theapi/dummy_load/README.md

# dummy_load
Constant current dummy load
