theapi/dummy_load/electronic_load.pdf

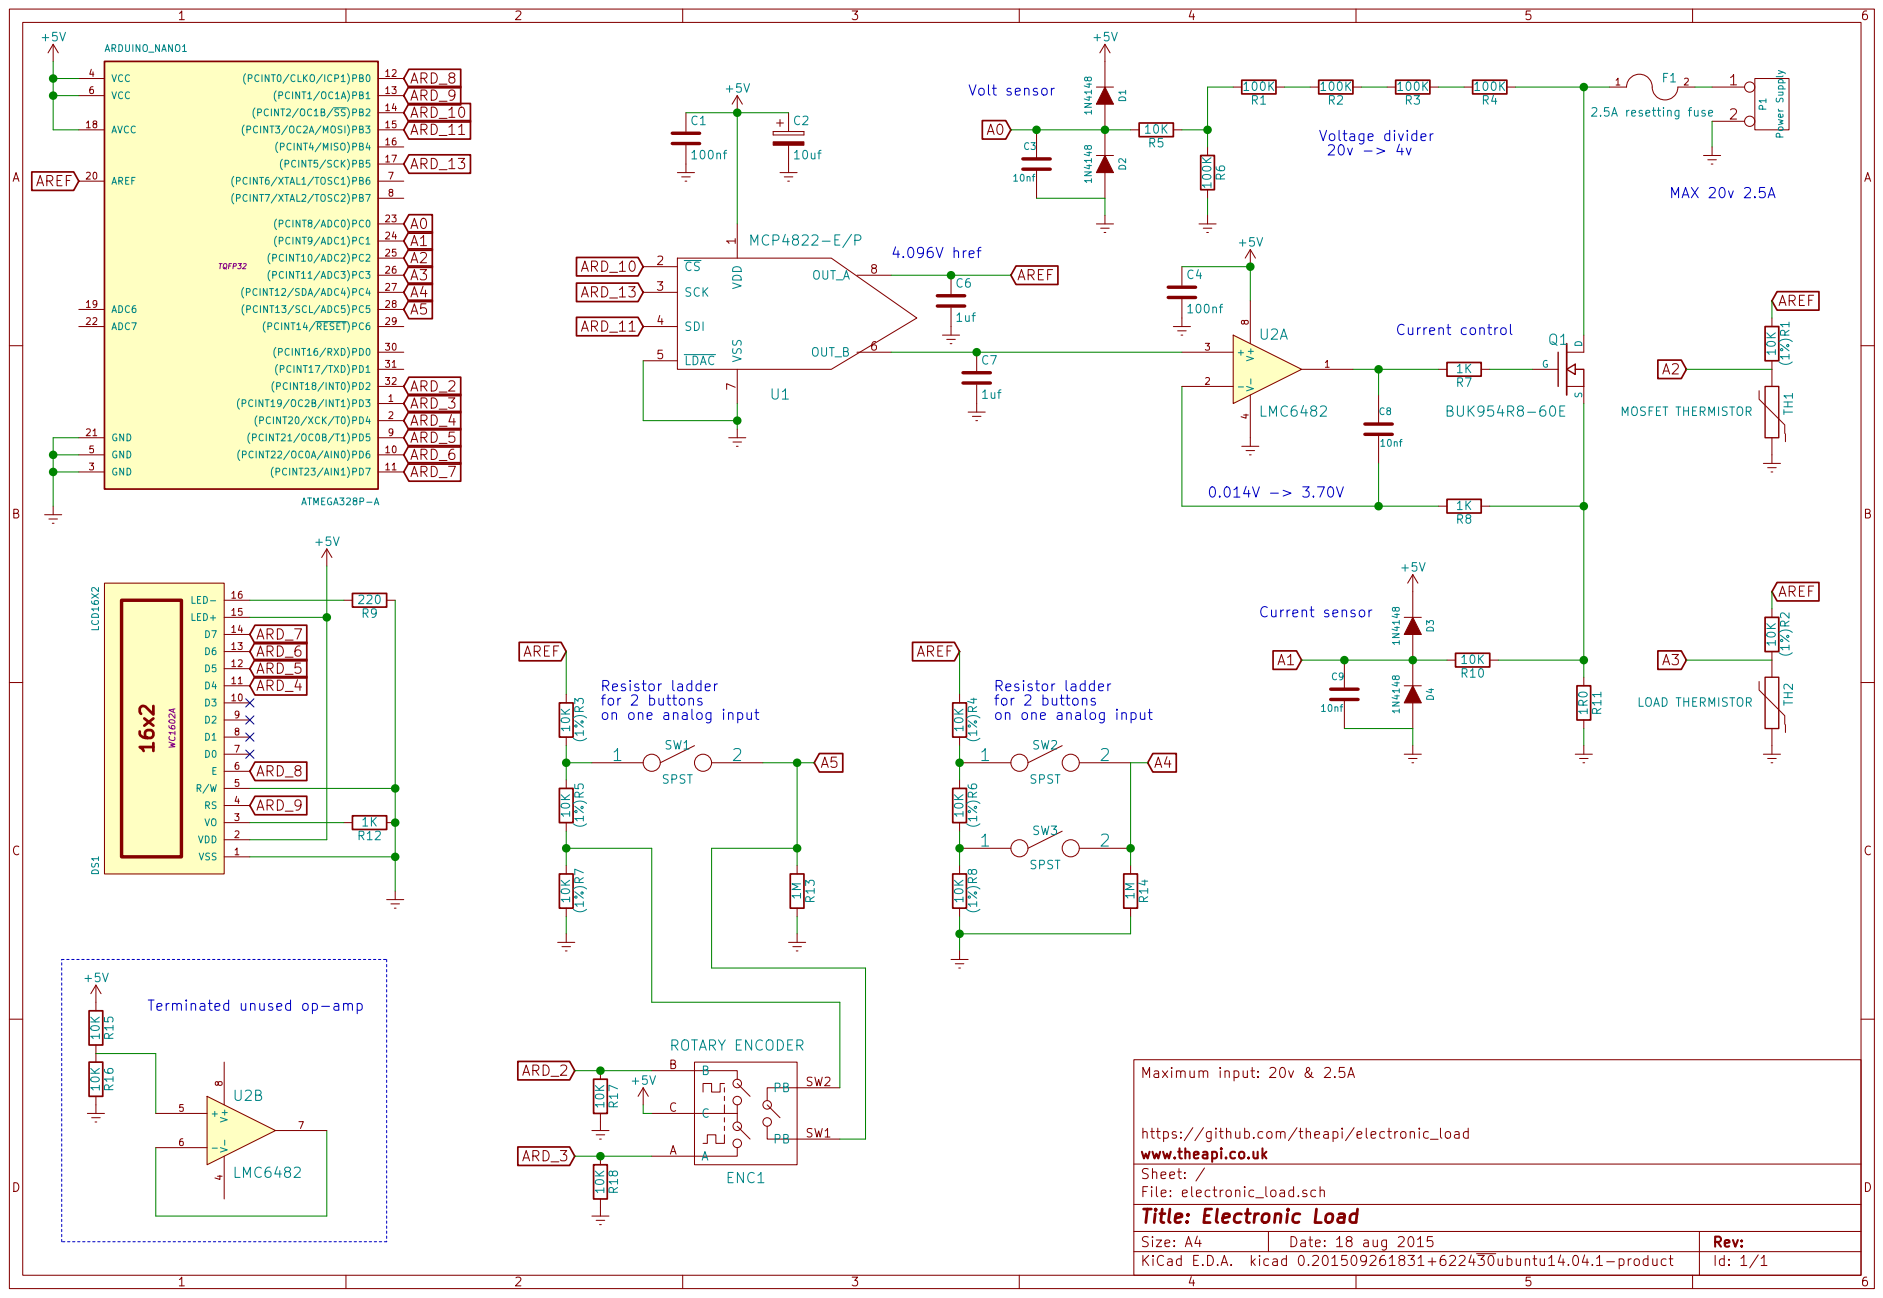
[picture p1: page 1]

for 2 buttons on one analog input

Terminated unused op-amp

https://github.com/theapi/electronic_load
File: electronic_load.sch Sheet: / www.theapi.co.uk

Id: 1/1 Title: Electronic Load
