theapi/dummy_load/(commit log)

2015-08-19 Changed pin assignments
2015-08-19 Schematic pdf
2015-08-19 Start of the rotary encoder
2015-08-19 Read & display the thermistors
2015-08-19 LDAC tied to low so the output latches on the rising edge of the CS pin.
2015-08-20 Read the rotary encoder
2015-08-20 Invert the rotary encoder counter & faster screen refresh
    [dummy_load.ino]
2015-08-21 pulldowns on the rotary encoder
2015-08-23 4v ahref from the adc
2015-08-23 Voltage output from DAC set by the rotary encoder
2015-08-24 Divide 1024 for adc conversion
2015-08-24 Better temperature reading
2015-08-25 Encoder switch
2015-08-25 Encode switch up/down
2015-08-25 Show minimum volts setting
2015-08-26 Resistor ladder
2015-08-26 Thermistor code tidying
2015-08-26 Start of the switches register
2015-08-27 Minimum volts
2015-08-27 Encoder switch on resistor ladder
2015-08-28 Read switches
2015-08-30 Adjust aref output to be 4v
2015-09-04 Blink "V" on setting minimum volts
2015-09-10 Switchs analog values
2015-09-20 Trimming the voltage reading
2015-09-20 Allow the ADC mux to settle on changing input
2015-09-20 milliamp padding on the screen
2015-09-20 Resistor values update
2015-09-25 Independent encoder readings for target load & minimum volts
2015-09-28 Hysteresis on minimum volt cut off
2015-09-28 Mosfet & opamp change
